yldztuna5/esp32-handheld/firmware/README.md

# Firmware

ESP32-S3 yazılımı (PlatformIO + Arduino). Henüz başlanmadı.
