yldztuna5/esp32-handheld/hardware/case/README.md

# Kasa

3D kasa tasarımı (PETG/ASA). PCB ölçüleri kesinleşince başlanacak.
