yldztuna5/esp32-handheld/hardware/pcb/handheld/render-bottom.png

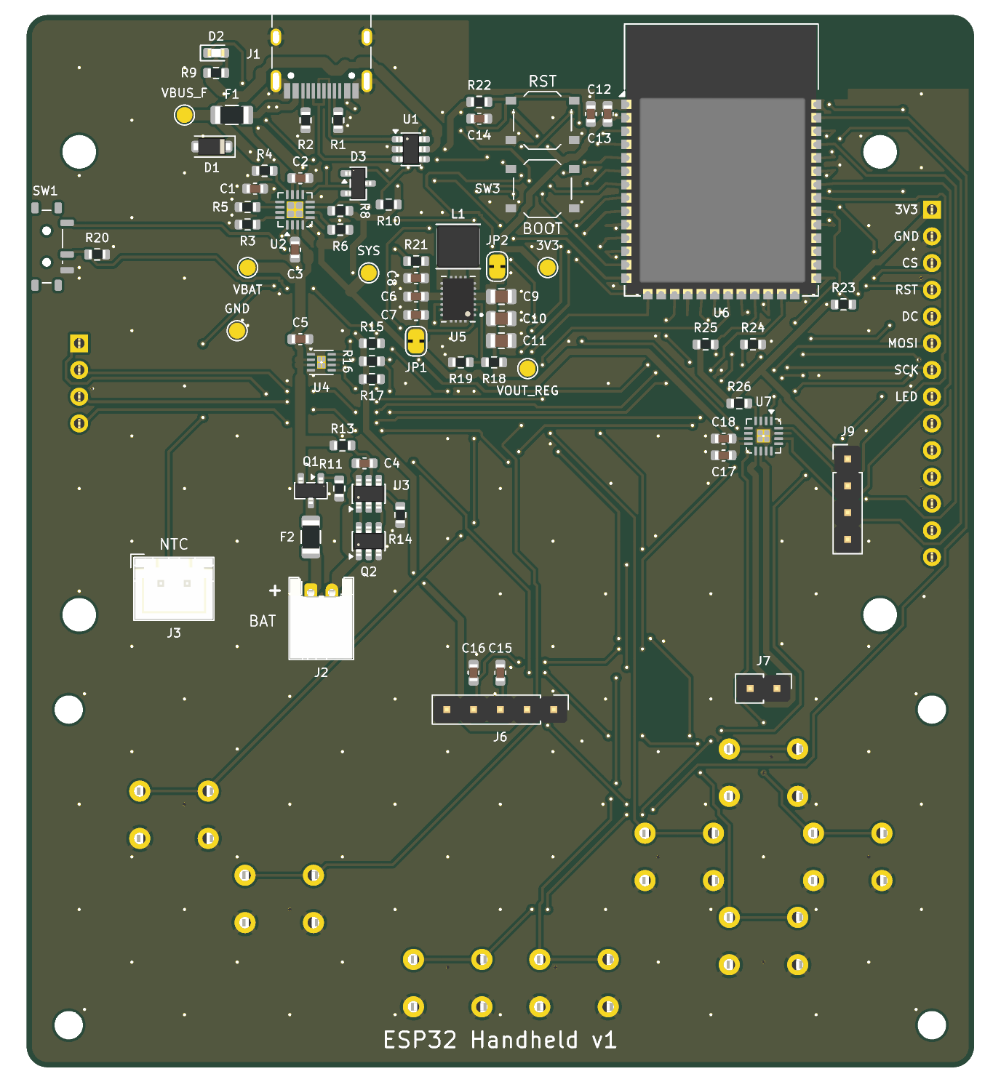
hardware/pcb/handheld/render-bottom.png
