yldztuna5/esp32-handheld/hardware/pcb/handheld/render-top.png

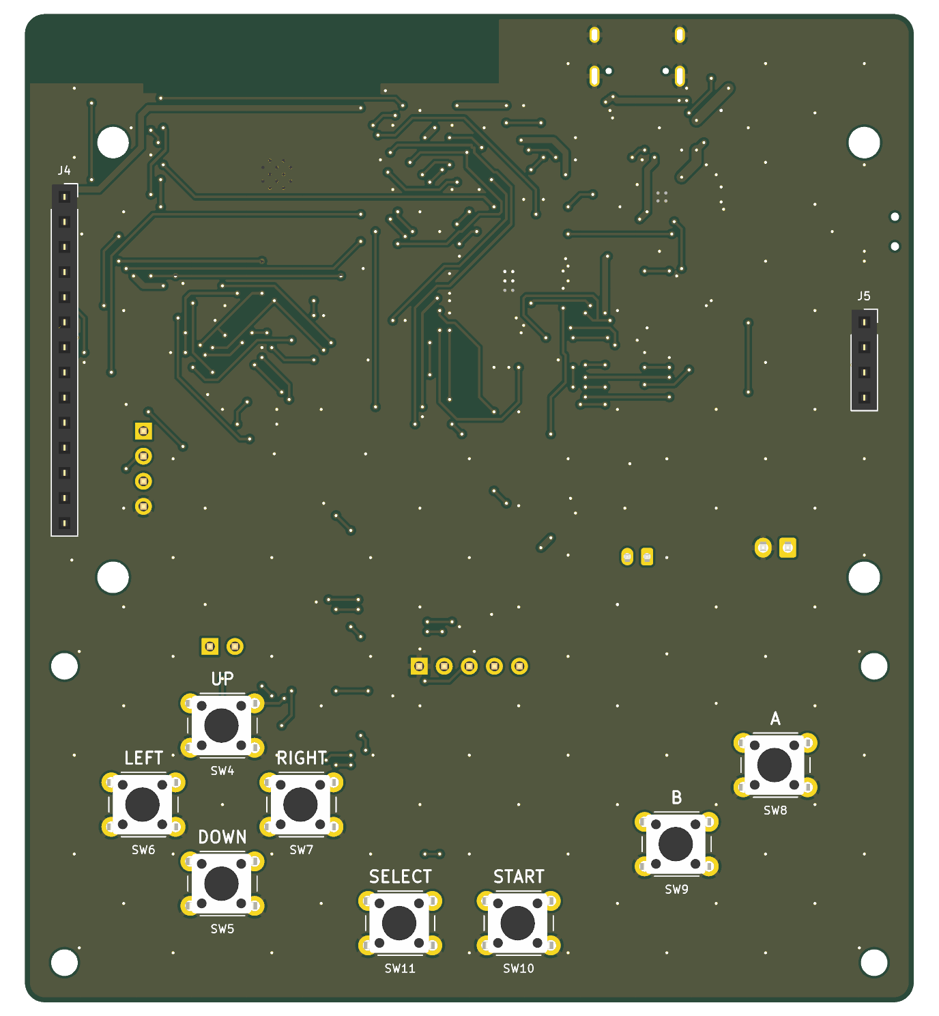
hardware/pcb/handheld/render-top.png
