yldztuna5/esp32-handheld/hardware/pcb/handheld/fab/bom-jlcpcb.csv

Comment | Designator | Footprint | LCSC Part #
1uF | C1,C14 | C_0603_1608Metric | C15849
10uF | C2,C3,C6,C7,C12,C17 | C_0603_1608Metric | C96446
100nF | C4,C5,C8,C13,C15,C16,C18 | C_0603_1608Metric | C14663
22uF | C9,C10,C11 | C_0805_2012Metric | C45783
SMF5.0A | D1 | D_SOD-123F | C193402
RED | D2 | LED_0603_1608Metric | C2286
BAT54 | D3 | SOT-23 | C8590
PTC 0.75A | F1 | Fuse_1206_3216Metric | C20987
2A | F2 | Fuse_1206_3216Metric | C3105
USB-C 16P | J1 | USB_C_Receptacle_HRO_TYPE-C-31-M-12 | C165948
1.5uH | L1 | L_Changjiang_FNR4020S | C167824
AO3401A | Q1 | SOT-23 | C15127
8205A | Q2 | SOT-23-6 | C351449
5.1k | R1,R2 | R_0603_1608Metric | C23186
1.78k | R3 | R_0603_1608Metric | C13118
1.5k | R4 | R_0603_1608Metric | C22843
68k | R5 | R_0603_1608Metric | C23231
10k | R6,R11,R17,R21,R22,R23,R25,R26 | R_0603_1608Metric | C25804
100k | R8,R10,R24 | R_0603_1608Metric | C25803
2.2k | R9 | R_0603_1608Metric | C4190
100R | R13 | R_0603_1608Metric | C22775
1k | R14 | R_0603_1608Metric | C21190
4.7k | R15,R16 | R_0603_1608Metric | C23162
1M | R18,R20 | R_0603_1608Metric | C22935
180k | R19 | R_0603_1608Metric | C22827
MSK12C02 | SW1 | SW_SPDT_Shouhan_MSK12C02 | C431540
RESET | SW2 | SW_Push_1P1T_XKB_TS-1187A | C318884
BOOT | SW3 | SW_Push_1P1T_XKB_TS-1187A | C318884
USBLC6-2SC6 | U1 | SOT-23-6 | C7519
BQ24074RGTR | U2 | VQFN-16-1EP_3x3mm_P0.5mm_EP1.6x1.6mm | C54313
DW01A | U3 | SOT-23-6 | C351410
MAX17048G+T10 | U4 | TDFN-8-1EP_2x2mm_P0.5mm_EP0.8x1.2mm | C2682616
TPS63020DSJR | U5 | TPS63020_DSJ | C15483
ESP32-S3-WROOM-1-N16R8 | U6 | ESP32-S3-WROOM-1 | C2913202
MAX98357AETE+T | U7 | TQFN-16-1EP_3x3mm_P0.5mm_EP1.23x1.23mm | C910544
