yldztuna5/esp32-handheld/hardware/pcb/handheld/handheld-schematic.pdf

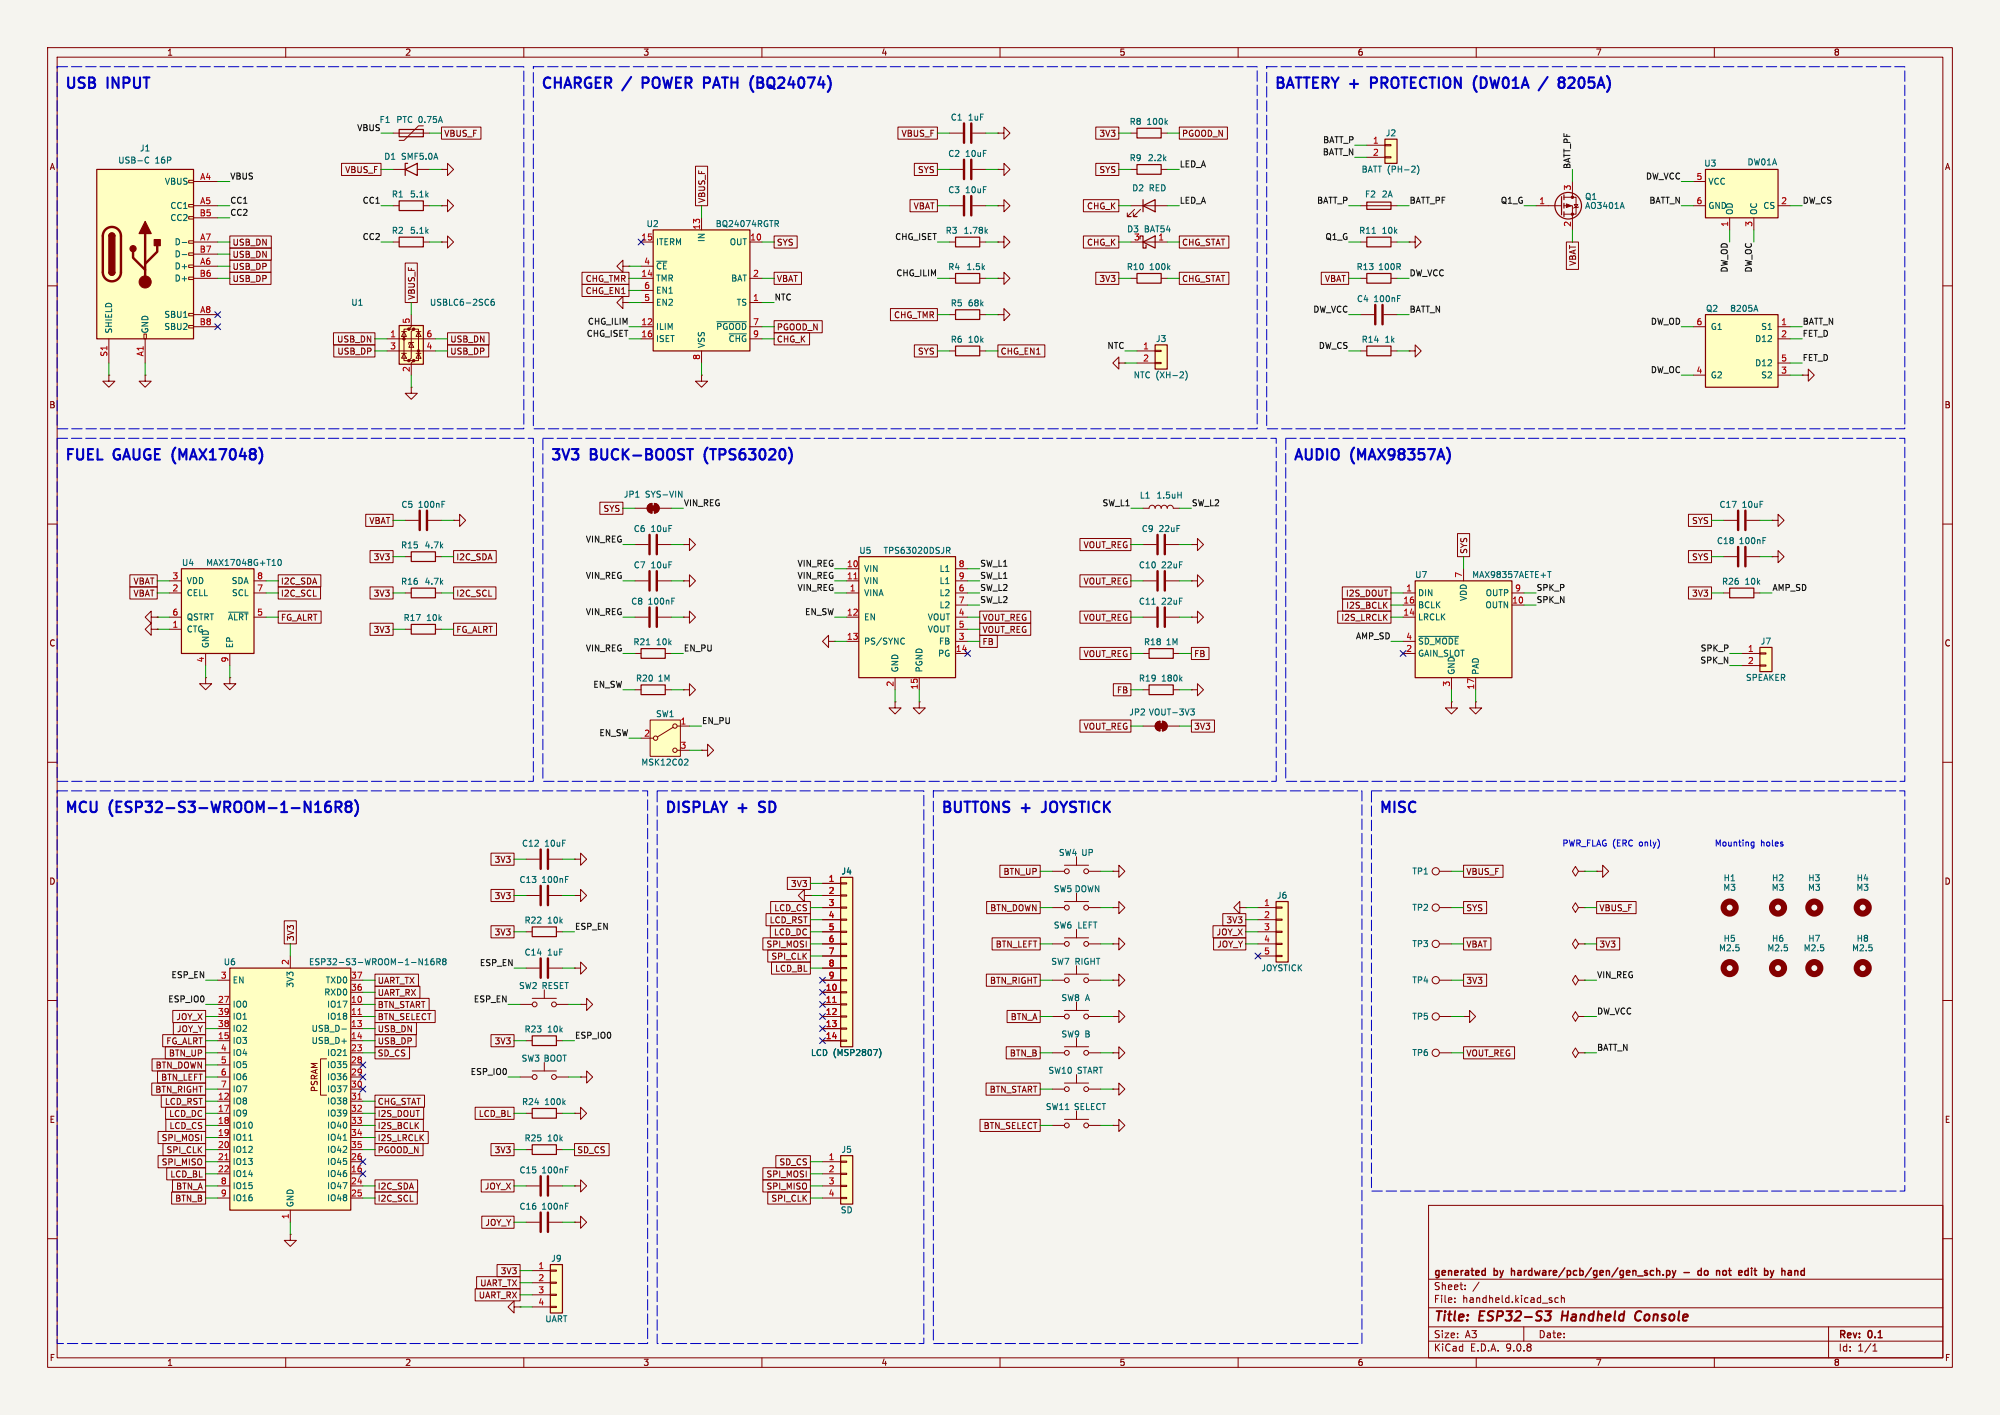
[picture p3: page 1]

8 OUT 10 BAT 2 TS 1 ~{PGOOD}7 ~{CHG}9 U2 BQ24074RGTR

7 PAD 17 OUTP 9 OUTN 10 U7 MAX98357AETE+T SW10 START SW11 SELECT SW8 A
