yldztuna5/esp32-handheld/hardware/pcb/handheld/handheld.kicad_pcb

## KiCad design hardware/pcb/handheld/handheld.kicad_pcb (2026-11-12)

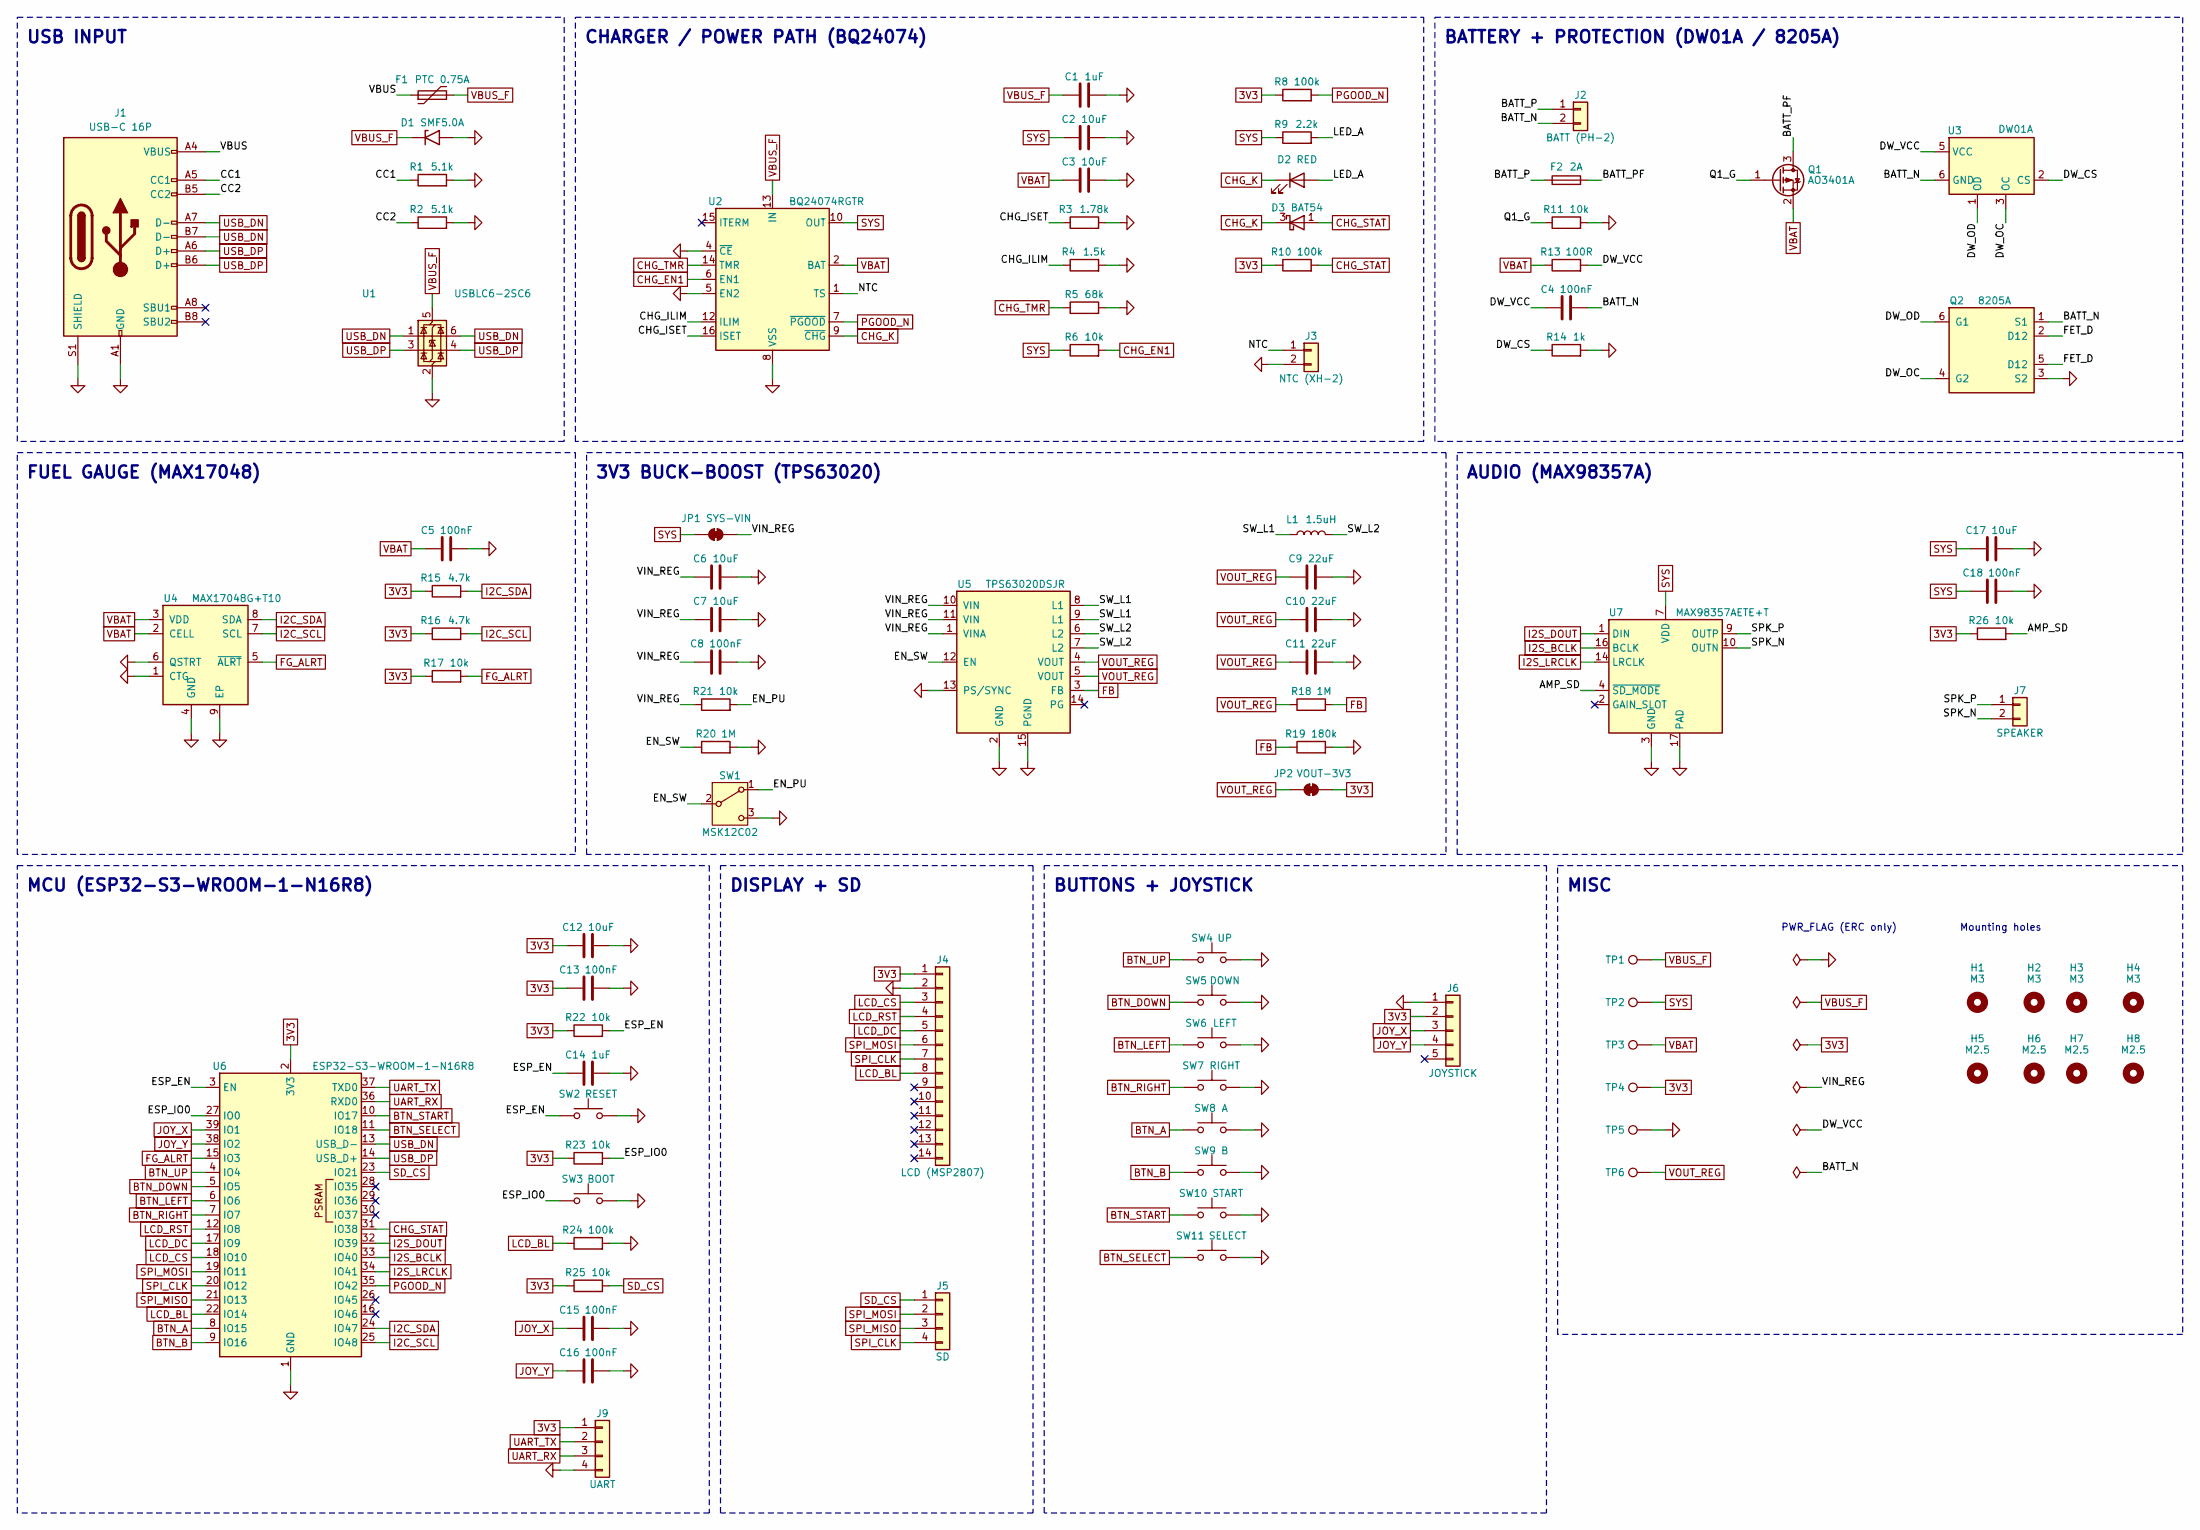
[picture p4: schematic handheld.kicad_sch, ESP32-S3 Handheld Console]

Parts:
C1, C14: 1uF; C_0603_1608Metric; LCSC C15849
C2, C3, C6, C7, C12, C17: 10uF; C_0603_1608Metric; LCSC C96446
C4, C5, C8, C13, C15, C16, C18: 100nF; C_0603_1608Metric; LCSC C14663
C9, C10, C11: 22uF; C_0805_2012Metric; LCSC C45783
D1: SMF5.0A; D_SOD-123F; LCSC C193402
D2: RED; LED_0603_1608Metric; LCSC C2286
D3: BAT54; SOT-23; LCSC C8590
F1: PTC 0.75A; Fuse_1206_3216Metric; LCSC C20987
F2: 2A; Fuse_1206_3216Metric; LCSC C3105
H1, H2, H3, H4: M3; MountingHole_3.2mm_M3
H5, H6, H7, H8: M2.5; MountingHole_2.7mm_M2.5
J1: USB-C 16P; USB_C_Receptacle_HRO_TYPE-C-31-M-12; LCSC C165948
J2: BATT (PH-2); JST_PH_S2B-PH-K_1x02_P2.00mm_Horizontal
J3: NTC (XH-2); JST_XH_B2B-XH-A_1x02_P2.50mm_Vertical
J4: LCD (MSP2807); PinSocket_1x14_P2.54mm_Vertical
J5: SD; PinSocket_1x04_P2.54mm_Vertical
J6: JOYSTICK; PinHeader_1x05_P2.54mm_Vertical
J7: SPEAKER; PinHeader_1x02_P2.54mm_Vertical
J9: UART; PinHeader_1x04_P2.54mm_Vertical
JP1: SYS-VIN; SolderJumper-2_P1.3mm_Bridged_RoundedPad1.0x1.5mm
JP2: VOUT-3V3; SolderJumper-2_P1.3mm_Bridged_RoundedPad1.0x1.5mm
L1: 1.5uH; L_Changjiang_FNR4020S; LCSC C167824
Q1: AO3401A; SOT-23; LCSC C15127
Q2: 8205A; SOT-23-6; LCSC C351449
R1, R2: 5.1k; R_0603_1608Metric; LCSC C23186
R3: 1.78k; R_0603_1608Metric; LCSC C13118
R4: 1.5k; R_0603_1608Metric; LCSC C22843
R5: 68k; R_0603_1608Metric; LCSC C23231
R6, R11, R17, R21, R22, R23, R25, R26: 10k; R_0603_1608Metric; LCSC C25804
R8, R10, R24: 100k; R_0603_1608Metric; LCSC C25803
R9: 2.2k; R_0603_1608Metric; LCSC C4190
R13: 100R; R_0603_1608Metric; LCSC C22775
R14: 1k; R_0603_1608Metric; LCSC C21190
R15, R16: 4.7k; R_0603_1608Metric; LCSC C23162
R18, R20: 1M; R_0603_1608Metric; LCSC C22935
R19: 180k; R_0603_1608Metric; LCSC C22827
SW1: MSK12C02; SW_SPDT_Shouhan_MSK12C02; LCSC C431540
SW2: RESET; SW_Push_1P1T_XKB_TS-1187A; LCSC C318884
SW3: BOOT; SW_Push_1P1T_XKB_TS-1187A; LCSC C318884
SW4: UP; SW_PUSH_6mm
SW5: DOWN; SW_PUSH_6mm
SW6: LEFT; SW_PUSH_6mm
SW7: RIGHT; SW_PUSH_6mm
SW8: A; SW_PUSH_6mm
SW9: B; SW_PUSH_6mm
SW10: START; SW_PUSH_6mm
SW11: SELECT; SW_PUSH_6mm
TP1: VBUS_F; TestPoint_Pad_D1.5mm
TP2: SYS; TestPoint_Pad_D1.5mm
TP3: VBAT; TestPoint_Pad_D1.5mm
TP4: 3V3; TestPoint_Pad_D1.5mm
TP5: GND; TestPoint_Pad_D1.5mm
TP6: VOUT_REG; TestPoint_Pad_D1.5mm
U1: USBLC6-2SC6; SOT-23-6; LCSC C7519
U2: BQ24074RGTR; VQFN-16-1EP_3x3mm_P0.5mm_EP1.6x1.6mm; LCSC C54313
U3: DW01A; SOT-23-6; LCSC C351410
U4: MAX17048G+T10; TDFN-8-1EP_2x2mm_P0.5mm_EP0.8x1.2mm; LCSC C2682616
U5: TPS63020DSJR; TPS63020_DSJ; LCSC C15483
U6: ESP32-S3-WROOM-1-N16R8; ESP32-S3-WROOM-1; LCSC C2913202
U7: MAX98357AETE+T; TQFN-16-1EP_3x3mm_P0.5mm_EP1.23x1.23mm; LCSC C910544

Connections:
3V3: C12.1, C13.1, J4.1, J6.2, J9.1, JP2.2 (B), R8.1, R10.1, R15.1, R16.1, R17.1, R22.1, R23.1, R25.1, R26.1, TP4.1, U6.2 (3V3)
/AMP_SD: R26.2, U7.4 (~SD_MODE)
/BATT_N: C4.2, J2.2, Q2.1 (S1), U3.6 (GND)
/BATT_P: F2.1, J2.1
/BATT_PF: F2.2, Q1.3 (D)
/CC1: J1.A5 (CC1), R1.1
/CC2: J1.B5 (CC2), R2.1
/CHG_ILIM: R4.1, U2.12 (ILIM)
/CHG_ISET: R3.1, U2.16 (ISET)
/DW_CS: R14.1, U3.2 (CS)
/DW_OC: Q2.4 (G2), U3.3 (OC)
/DW_OD: Q2.6 (G1), U3.1 (OD)
/DW_VCC: C4.1, R13.2, U3.5 (VCC)
/EN_PU: R21.2, SW1.1 (A)
/EN_SW: R20.1, SW1.2 (B), U5.12 (EN)
/ESP_EN: C14.1, R22.2, SW2.1, U6.3 (EN)
/ESP_IO0: R23.2, SW3.1, U6.27 (IO0)
/FET_D: Q2.2 (D12), Q2.5 (D12)
/LED_A: D2.2 (A), R9.2
/NTC: J3.1, U2.1 (TS)
/Q1_G: Q1.1 (G), R11.1
/SPK_N: J7.2, U7.10 (OUTN)
/SPK_P: J7.1, U7.9 (OUTP)
/SW_L1: L1.1, U5.8 (L1), U5.9 (L1)
/SW_L2: L1.2, U5.6 (L2), U5.7 (L2)
/VBUS: F1.1, J1.A4 (VBUS), J1.A9 (VBUS), J1.B4 (VBUS), J1.B9 (VBUS)
/VIN_REG: C6.1, C7.1, C8.1, JP1.2 (B), R21.1, U5.1 (VINA), U5.10 (VIN), U5.11 (VIN)
BTN_A: SW8.1, U6.8 (IO15)
BTN_B: SW9.1, U6.9 (IO16)
BTN_DOWN: SW5.1, U6.5 (IO5)
BTN_LEFT: SW6.1, U6.6 (IO6)
BTN_RIGHT: SW7.1, U6.7 (IO7)
BTN_SELECT: SW11.1, U6.11 (IO18)
BTN_START: SW10.1, U6.10 (IO17)
BTN_UP: SW4.1, U6.4 (IO4)
CHG_EN1: R6.2, U2.6 (EN1)
CHG_K: D2.1 (K), D3.3 (K), U2.9 (~CHG)
CHG_STAT: D3.1 (A), R10.2, U6.31 (IO38)
CHG_TMR: R5.1, U2.14 (TMR)
FB: R18.2, R19.1, U5.3 (FB)
FG_ALRT: R17.2, U4.5 (~ALRT), U6.15 (IO3)
GND: C1.2, C2.2, C3.2, C5.2, C6.2, C7.2, C8.2, C9.2, C10.2, C11.2, C12.2, C13.2, C14.2, C15.2, C16.2, C17.2, C18.2, D1.2 (A2), J1.A1 (GND), J1.A12 (GND), J1.B1 (GND), J1.B12 (GND), J1.S1 (SHIELD), J3.2, J4.2, J6.1, J9.4, Q2.3 (S2), R1.2, R2.2, R3.2, R4.2, R5.2, R11.2, R14.2, R19.2, R20.2, R24.2, SW1.3 (C), SW2.2, SW3.2, SW4.2, SW5.2, SW6.2, SW7.2, SW8.2, SW9.2, SW10.2, SW11.2, TP5.1, U1.2 (GND), U2.4 (~CE), U2.5 (EN2), U2.8 (VSS), U2.17 (VSS), U4.1 (CTG), U4.4 (GND), U4.6 (QSTRT), U4.9 (EP), U5.2 (GND), U5.13 (PS/SYNC), U5.15 (PGND), U6.1 (GND), U6.40 (GND), U6.41 (GND), U7.3 (GND), U7.11 (GND), U7.15 (GND), U7.17 (PAD)
I2C_SCL: R16.2, U4.7 (SCL), U6.25 (IO48)
I2C_SDA: R15.2, U4.8 (SDA), U6.24 (IO47)
I2S_BCLK: U6.33 (IO40), U7.16 (BCLK)
I2S_DOUT: U6.32 (IO39), U7.1 (DIN)
I2S_LRCLK: U6.34 (IO41), U7.14 (LRCLK)
JOY_X: C15.1, J6.3, U6.39 (IO1)
JOY_Y: C16.1, J6.4, U6.38 (IO2)
LCD_BL: J4.8, R24.1, U6.22 (IO14)
LCD_CS: J4.3, U6.18 (IO10)
LCD_DC: J4.5, U6.17 (IO9)
LCD_RST: J4.4, U6.12 (IO8)
PGOOD_N: R8.2, U2.7 (~PGOOD), U6.35 (IO42)
SD_CS: J5.1, R25.2, U6.23 (IO21)
SPI_CLK: J4.7, J5.4, U6.20 (IO12)
SPI_MISO: J5.3, U6.21 (IO13)
SPI_MOSI: J4.6, J5.2, U6.19 (IO11)
SYS: C2.1, C17.1, C18.1, JP1.1 (A), R6.1, R9.1, TP2.1, U2.10 (OUT), U2.11 (OUT), U7.7 (VDD), U7.8 (VDD)
UART_RX: J9.3, U6.36 (RXD0)
UART_TX: J9.2, U6.37 (TXD0)
USB_DN: J1.A7 (D-), J1.B7 (D-), U1.1 (I/O1), U1.6 (I/O1), U6.13 (USB_D-)
USB_DP: J1.A6 (D+), J1.B6 (D+), U1.3 (I/O2), U1.4 (I/O2), U6.14 (USB_D+)
VBAT: C3.1, C5.1, Q1.2 (S), R13.1, TP3.1, U2.2 (BAT), U2.3 (BAT), U4.2 (CELL), U4.3 (VDD)
VBUS_F: C1.1, D1.1 (A1), F1.2, TP1.1, U1.5 (VBUS), U2.13 (IN)
VOUT_REG: C9.1, C10.1, C11.1, JP2.1 (A), R18.1, TP6.1, U5.4 (VOUT), U5.5 (VOUT)

Notes on the sheet:
USB INPUT
CHARGER / POWER PATH (BQ24074)
BATTERY + PROTECTION (DW01A / 8205A)
FUEL GAUGE (MAX17048)
3V3 BUCK-BOOST (TPS63020)
AUDIO (MAX98357A)
MCU (ESP32-S3-WROOM-1-N16R8)
DISPLAY + SD
BUTTONS + JOYSTICK
MISC
PWR_FLAG (ERC only)
Mounting holes

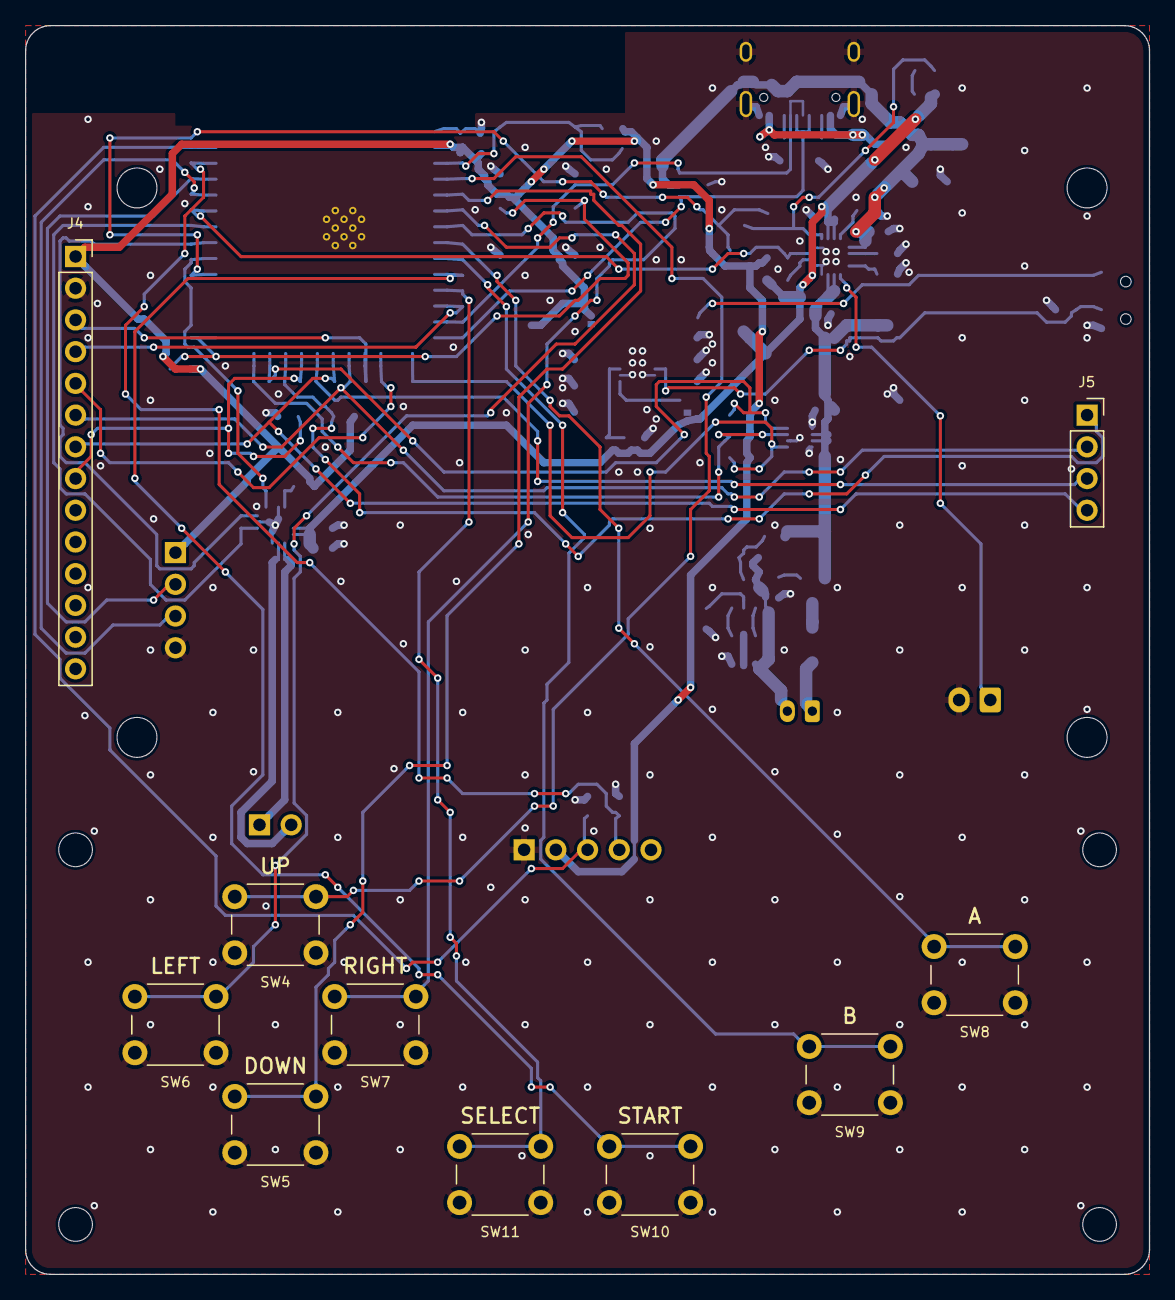
[picture p5: board handheld.kicad_pcb from above]

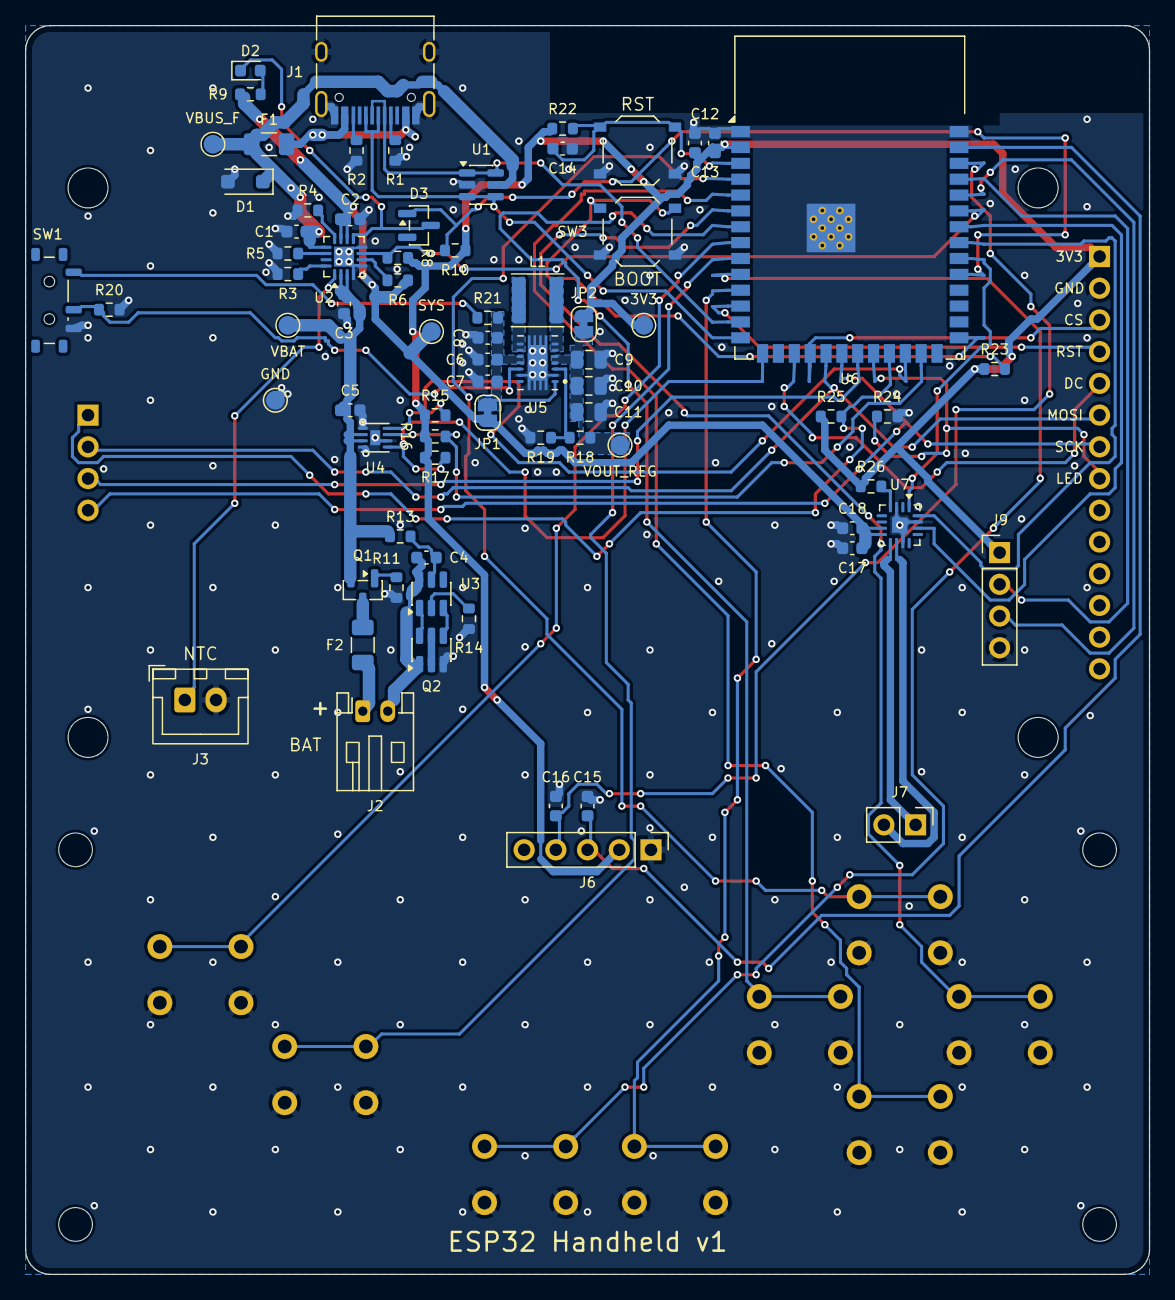
[picture p6: board handheld.kicad_pcb from below]

Board: 2 copper layers, 90.0 x 100.0 mm, 92 parts (74 on the bottom side), 66 nets.
