yldztuna5/esp32-handheld/(commit log)

2026-10-24 Add parts list, switch display to header module
2026-10-24 Update parts list with final prototype carts
2026-10-24 Keep IPS display, reuse amp module on PCB
2026-10-24 Add pin plan, switch to PAM8403 and XY joystick
2026-11-11 Switch to TN display, apply design review fixes
    Display: ILI9341 TN module instead of Waveshare IPS (budget). SD on shared SPI.
    Power: 500 mA charge with USB500 input limit, B3950 NTC, longer safety timer, switch on regulator EN, TPS63021, battery fuse and reverse-polarity protection.
    Controls: D-pad as primary input, joystick optional.
    Audio: I2S amp chip on PCB, PAM8403 only on breadboard with attenuator.
2026-11-11 Add KiCad schematic generator and schematic
    Circuit defined in hardware/pcb/gen/design.py; schematic, netlist check, BOM and TPS63020 footprint are generated from it. ERC: 0 errors.
    [bom-jlcpcb.csv, handheld.kicad_sch]
2026-11-11 Add PCB layout v1 draft and fabrication files
    90 x 100 mm, 2 layers, SMD on the back. DRC: 0 errors, 0 unconnected, schematic parity OK. Regulator changed to TPS63020 (TPS63021 out of stock). Draft: power track widths and JLCPCB rotations still to be reviewed before ordering.
    [bom-jlcpcb.csv, handheld.kicad_pcb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]
2026-11-12 Widen power tracks on PCB
    Main current paths are now at least 0.6 mm (battery chain 1.0 mm), routed as fixed trunks before the signal router. DRC: 0 errors, 0 unconnected.
    [handheld.kicad_pcb]
2026-11-12 Plan case at 94 x 130 mm with battery bay below the board
2026-11-12 Clarify charge termination in module build
2026-11-12 Add fuse, thermal cutoff and branded cell to module build
2026-11-12 Add perfboard layout generator, drawings and wiring table
2026-11-12 Add headers, standoffs and wire to parts list
